khanmark/redcat51-flat-panel/docs/images/exploded.png

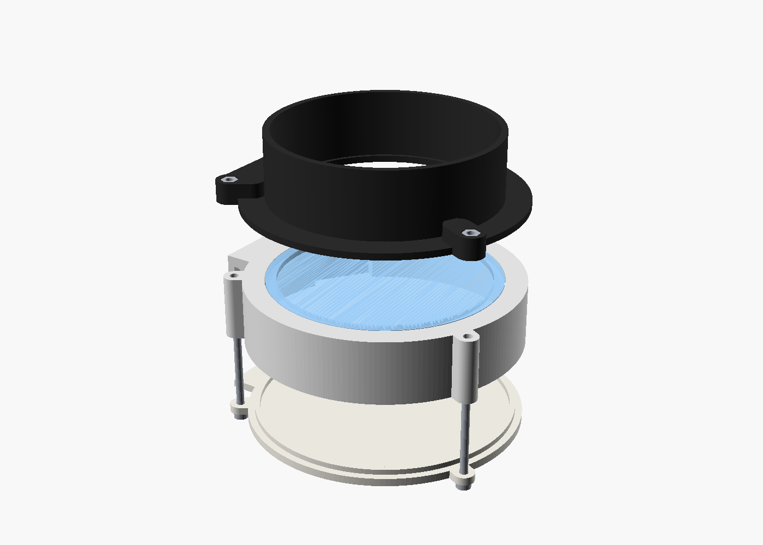
docs/images/exploded.png
