khanmark/redcat51-flat-panel/docs/images/nut_pocket_detail.png

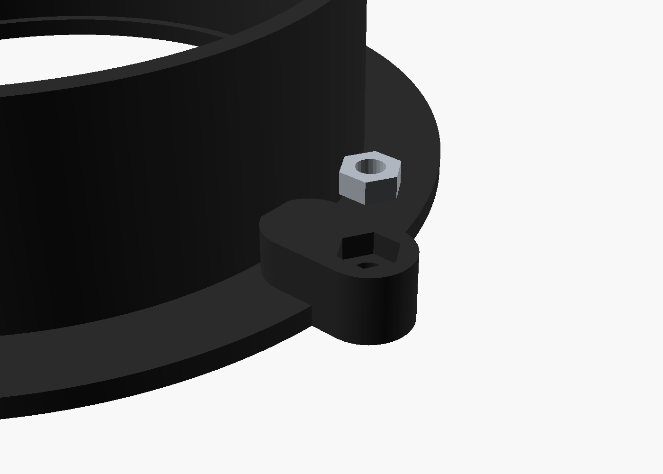
docs/images/nut_pocket_detail.png
