khanmark/redcat51-flat-panel/optional/flat_panel_collar_heat_insert.stl

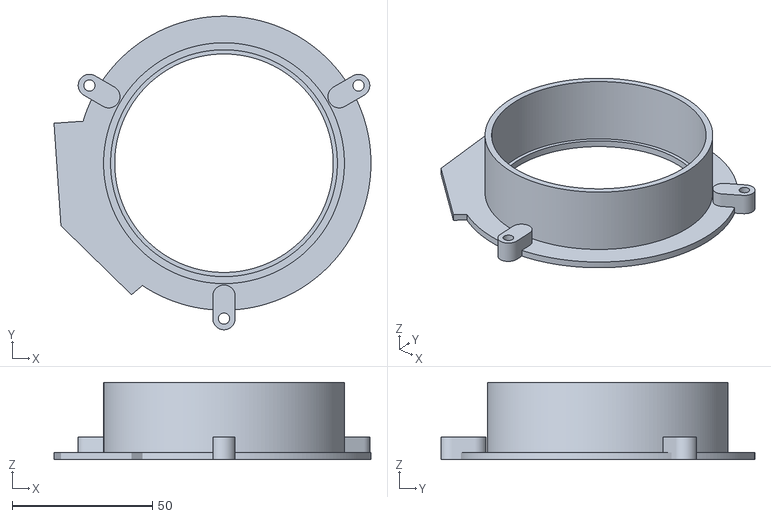
[picture p14: CAD file, 2026-10-26]
optional/flat_panel_collar_heat_insert.stl
113.2 x 112.0 x 27.5
