khanmark/redcat51-flat-panel/optional/flat_panel_diffuser_0.6mm.stl

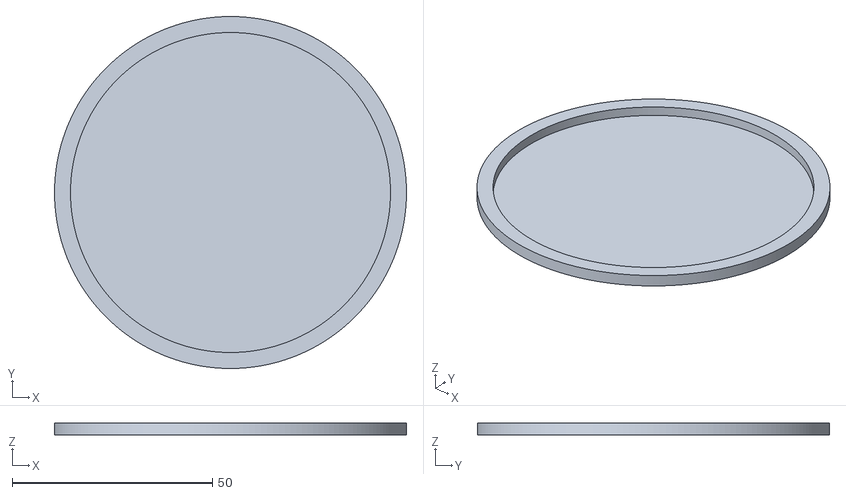
[picture p15: CAD file, 2026-10-26]
optional/flat_panel_diffuser_0.6mm.stl
88.0 x 88.0 x 3.00
