khanmark/redcat51-flat-panel/stl/flat_panel_diffuser.stl

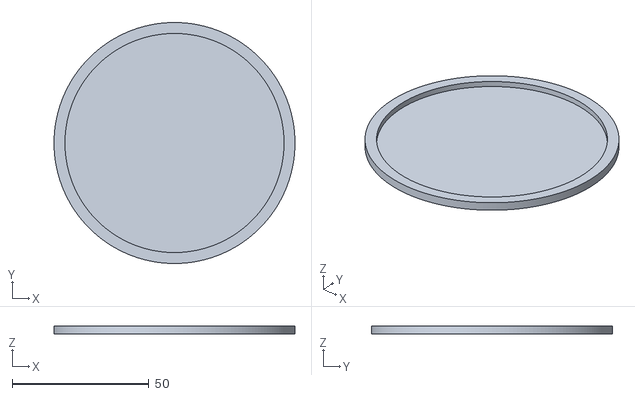
[picture p16: CAD file, 2026-10-26]
stl/flat_panel_diffuser.stl
88.0 x 88.0 x 3.00
