khanmark/redcat51-flat-panel/optional/acrylic_diffuser_88mm.dxf

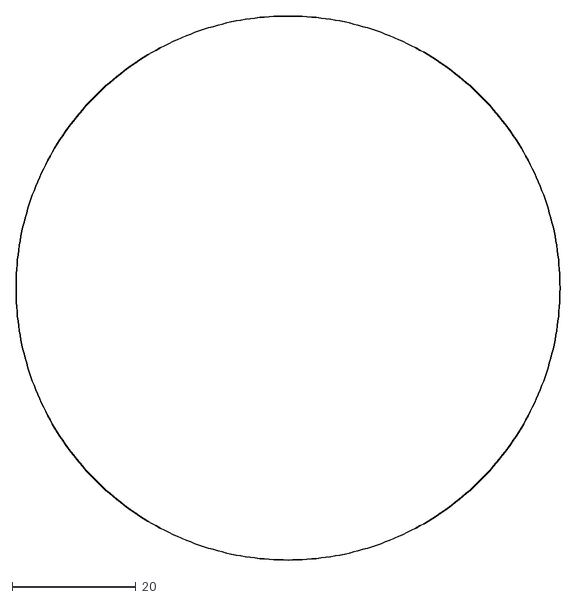
[picture p17: CAD file, 2026-10-26]
optional/acrylic_diffuser_88mm.dxf
88.0 x 88.0
