khanmark/redcat51-flat-panel/stl/flat_panel_surround.stl

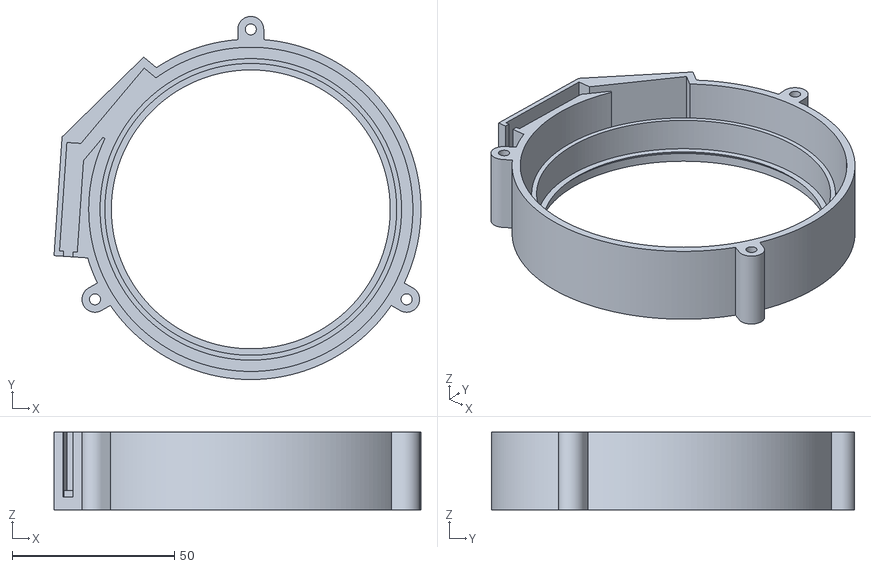
[picture p18: CAD file, 2026-10-26]
stl/flat_panel_surround.stl
113.2 x 112.0 x 24.0
