khanmark/redcat51-flat-panel/stl/flat_panel_back.stl

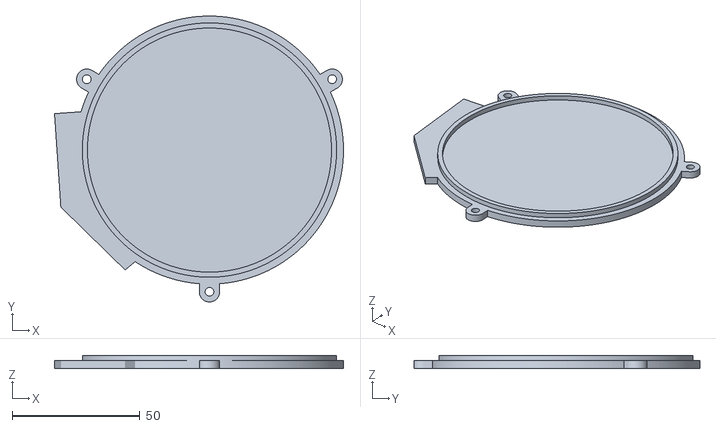
[picture p19: CAD file, 2026-10-26]
stl/flat_panel_back.stl
113.2 x 112.0 x 5.00
