khanmark/redcat51-flat-panel/scad/flat_panel.scad

// Slip-on flat-field panel for the William Optics RedCat 51 II.
//
// QUICK START: pick a part below, render (F6) and export (File > Export > STL).
// Or run scad/export_stls.sh to export every STL in one go. For a different scope, change only
// collar_id and diffuser_d (see the README appendix); everything else follows from those two.
//
// Print orientations (as modelled, no supports):
//   back       - flat on the bed, spigot up. Print in WHITE (exported mirrored, see the bottom of this file)
//   surround   - front face (diffuser recess) down
//   collar     - flange down; an M3 nut pocket in the free end of each tab (exported mirrored)
//   diffuser   - flat face on the bed, rim up
//   collar_heat_insert - optional collar for M3 heat-set inserts instead of nuts (exported mirrored)
//
// Assembly, front to back: collar flange -> diffuser (in the surround's front recess) -> surround -> back wall.
// Three M3x35 bolts go in from the back wall, through the surround lugs and collar tabs, into the nuts.

part = "all"; // [all, exploded, collar, surround, back, diffuser, collar_heat_insert]

/* [Fit to your scope] */
collar_id    = 81;    // inside diameter of the slip-on collar: measure your scope's dew shield and add about 1 mm
collar_depth = 25;    // how far the collar slides on

/* [Diffuser] */
diffuser_d        = 88;   // diffuser disc diameter
diffuser_t        = 3;    // recess depth = disc thickness at its edge (the collar flange clamps it)
diffuser_center_t = 1.0;  // thickness of the thin light-passing centre (the optional thinner diffuser uses 0.6)
diffuser_rim_w    = 4;    // width of the raised rim (keep it under the collar flange: > diffuser_d/2 - lip_id/2)

/* [Cavity] */
cavity_depth = 20;    // LED chamber depth. Deeper keeps bigger panels even (see the README appendix)

/* [Advanced: the defaults fit the parts in the BOM] */
wall         = 2.5;   // wall thickness of the collar and surround
flange_t     = 2.5;   // collar flange that clamps the diffuser
front_t      = 4;     // front ring thickness (includes the diffuser recess)
skirt_t      = 1.5;   // baffle skirt thickness (the skirt hides the LEDs from the diffuser)
back_t       = 3;     // back wall plate
spigot_h     = 2;     // locating ring on the back wall
spigot_w     = 2;
spigot_clear = 0.2;   // per side
// Wire exit: an open slot through the side of the connector box, so the wires leave the connector straight
wire_angle   = 140;   // where around the circle the connector box and converter pocket sit
slot_w       = 4;     // radial width of the connector-to-converter slot
dc_slot_w    = 3;     // DC lead exit slot in the far end of the converter pocket
// Strip connector: a solderless clip that slides down a channel from the open back (a soldered joint fits too)
conn_w       = 11.5;  // across the strip (axial)
conn_l       = 13.5;  // along the strip (tangential)
conn_t       = 4.2;   // thickness (radial)
conn_clear   = 0.5;
// Buck converter ("puck") pocket: outside the main wall, next to the side slot; slides in from the back
puck_l       = 25.5;  // along the wall
puck_w       = 17;    // front-to-back
puck_t       = 4.5;   // thickness
puck_clear   = 0.5;
puck_clear_l = 4;     // extra room along the wall (per end) for leads and fingers
puck_wall    = 1.6;
// Fasteners
lug_d        = 8;
screw_clear  = 3.4;
insert_d     = 4.0;   // heat-insert collar only: tab hole size, check your insert's recommended hole
insert_tab_t = 8;
lug_angles   = [90, 210, 330];
// Nut pockets: a hex nut sits in a pocket in the free (scope-side) end of each collar tab
nut_af       = 5.5;   // M3 nut, across flats
nut_h        = 2.4;   // M3 nut thickness
nut_clear    = 0.2;   // extra clearance per side (raise it if your nuts will not drop in)
nut_tab_d    = 10;    // collar tab width with nut pockets (wider than lug_d so the pocket keeps walls)

/* [Hidden] */
// Worked out from collar_id, diffuser_d and cavity_depth. They are not Customizer knobs, but you can still
// override any of them from the command line, e.g. -D skirt_len=17
lip_id            = collar_id - 3;        // internal stop lip: the scope bottoms out here (must clear your optics)
diffuser_recess_d = diffuser_d + 0.5;     // recess the disc sits in
seat_id           = diffuser_d - 2;       // light opening; the disc rests on this ring
skirt_id          = diffuser_d + 2;
cavity_id         = diffuser_d + 12;      // room for the skirt, LED strip and its wall
skirt_len         = cavity_depth / 2;     // never less than your strip width (10 mm)

$fn = 180;

outer_d    = cavity_id + 2 * wall;          // 105
lug_r      = outer_d / 2 + lug_d / 2 - 1;   // 55.5
surround_h = front_t + cavity_depth;        // 24

module lug_pads(h, d = lug_d) {
    for (a = lug_angles) rotate(a) hull() {
        translate([lug_r, 0, 0]) cylinder(d = d, h = h);
        translate([outer_d / 2 - 5, 0, 0]) cylinder(d = d, h = h);
    }
}

module lug_holes(d, h) {
    for (a = lug_angles) rotate(a)
        translate([lug_r, 0, -1]) cylinder(d = d, h = h + 2);
}

skirt_or   = skirt_id / 2 + skirt_t;                  // 46.5
chan_extra = 2;                                       // extra outward room so wires can exit beside the main wall
chan_out_r = skirt_or + conn_t + conn_clear + chan_extra;  // 53.2 - outer face of the connector channel
chan_len   = conn_l + 2 * conn_clear + 10;            // tangential length: connector + ~5mm each end for the wire bend
bump_wall  = 2.3;

// local thickening of the outer wall so the channel has a wall behind it
module conn_bump(h = surround_h) {
    rotate(wire_angle) translate([cavity_id / 2 - 2, -(chan_len / 2 + 2.5), 0])
        cube([chan_out_r + bump_wall - (cavity_id / 2 - 2), chan_len + 5, h]);
}

// buck converter pocket, placed tangent to the main wall right after the connector box
wall_or      = outer_d / 2;                                       // 52.5
pk_in_l      = puck_l + 2 * puck_clear_l;                         // 33.5
pk_in_w      = puck_w + 2 * puck_clear;                           // 18
pk_in_t      = puck_t + 2 * puck_clear;                           // 5.5
pk_half      = pk_in_l / 2 + puck_wall;
bump_half    = chan_len / 2 + 2.5;
pk_angle     = wire_angle + (bump_half + pk_half) / wall_or * 180 / PI;
pk_floor     = surround_h - pk_in_w;                              // pocket open to the back edge

module puck_body(h = surround_h) {
    rotate(pk_angle) translate([cavity_id / 2 - 2, -pk_half, 0])
        cube([wall_or + pk_in_t + puck_wall - (cavity_id / 2 - 2), 2 * pk_half, h]);
}

// connector box + converter pocket as one continuous outside shape
module side_body(h = surround_h) { hull() { conn_bump(h); puck_body(h); } }

module puck_void() {
    rotate(pk_angle) {
        translate([wall_or, -pk_in_l / 2, pk_floor]) cube([pk_in_t, pk_in_l, surround_h]);
        // DC lead exit through the far end wall, open to the back edge
        translate([wall_or + (pk_in_t - dc_slot_w) / 2, pk_in_l / 2 - 1, front_t]) cube([dc_slot_w, puck_wall + 2, surround_h]);
    }
}

// open slot through one side wall of the box, from the front ring to the back edge (back wall closes the top)
module side_slot() {
    rotate(wire_angle) translate([chan_out_r - slot_w, chan_len / 2 - 1, front_t])
        cube([slot_w, 2.5 + 8, surround_h]);   // runs through into the buck converter pocket
}

// full-height channel at the strip-joint location; connector drops in from the back, rests on the front ring
module conn_channel() {
    rotate(wire_angle) translate([skirt_or + 0.5, -chan_len / 2, front_t])
        cube([chan_out_r - skirt_or - 0.5, chan_len, surround_h]);
}

module back_wall() {
    difference() {
        union() {
            cylinder(d = outer_d, h = back_t);
            side_body(back_t);     // match the surround's outline
            lug_pads(back_t);
            translate([0, 0, back_t]) difference() {
                cylinder(d = cavity_id - 2 * spigot_clear, h = spigot_h);
                translate([0, 0, -1])
                    cylinder(d = cavity_id - 2 * spigot_clear - 2 * spigot_w, h = spigot_h + 2);
            }
        }
        lug_holes(screw_clear, back_t + spigot_h);
    }
}

module surround() {
    difference() {
        union() {
            cylinder(d = outer_d, h = surround_h);
            lug_pads(surround_h);
            side_body();
        }
        translate([0, 0, front_t]) cylinder(d = cavity_id, h = surround_h);
        conn_channel();
        translate([0, 0, -1]) cylinder(d = seat_id, h = front_t + 2);
        // diffuser recess with a 45-degree seat (no flat overhang); 88mm disc lands flush with front face
        chamfer_h = (diffuser_recess_d - seat_id) / 2;
        flat_h    = diffuser_t - (diffuser_recess_d - diffuser_d) / 2;
        translate([0, 0, -1]) cylinder(d = diffuser_recess_d, h = flat_h + 1);
        translate([0, 0, flat_h - 0.01])
            cylinder(d1 = diffuser_recess_d, d2 = seat_id, h = chamfer_h + 0.01);
        lug_holes(screw_clear, surround_h);
        side_slot();
        puck_void();
    }
    translate([0, 0, front_t]) difference() {
        cylinder(d = skirt_id + 2 * skirt_t, h = skirt_len);
        translate([0, 0, -1]) cylinder(d = skirt_id, h = skirt_len + 2);
    }
}

// nut_pocket = true (default): an M3 nut pocket in the free end of each tab, open at the top as printed (flange
// down), so the nut drops in from above. The bolt (M3x35: 3 back wall + 24 surround + 8 tab) just reaches through
// the nut. nut_pocket = false: plain tabs with insert_d holes for heat-set inserts (part = "collar_heat_insert").
module collar(nut_pocket = true) {
    difference() {
        union() {
            cylinder(d = outer_d, h = flange_t);
            side_body(flange_t);   // match the surround's outline
            lug_pads(insert_tab_t, nut_pocket ? nut_tab_d : lug_d);
            cylinder(d = collar_id + 2 * wall, h = flange_t + collar_depth);
        }
        translate([0, 0, -1]) cylinder(d = lip_id, h = 100);
        translate([0, 0, flange_t]) cylinder(d = collar_id, h = 100);
        lug_holes(nut_pocket ? screw_clear : insert_d, insert_tab_t);
        if (nut_pocket) for (a = lug_angles) rotate(a)       // hex corners point along the tab, flats across it
            translate([lug_r, 0, insert_tab_t - (nut_h + 0.2)])
                cylinder(d = (nut_af + 2 * nut_clear) / cos(30), h = nut_h + 0.2 + 1, $fn = 6);
    }
}

// 3D-printed diffuser: a thin centre (diffuser_center_t) lets the light through, and a raised rim up to
// diffuser_t fills the rest of the recess so the collar flange still clamps the disc. The flat face is the
// back (LED side); the rim is on the front face, under the flange. If diffuser_center_t >= diffuser_t it is a plain disc.
module diffuser() {
    cylinder(d = diffuser_d, h = min(diffuser_center_t, diffuser_t));
    if (diffuser_center_t < diffuser_t) difference() {
        cylinder(d = diffuser_d, h = diffuser_t);
        translate([0, 0, -1]) cylinder(d = diffuser_d - 2 * diffuser_rim_w, h = diffuser_t + 2);
    }
}

module assembly(gap = 0) {
    collar();
    translate([0, 0, -gap]) mirror([0, 0, 1]) surround();
    translate([0, 0, -surround_h - back_t - 2 * gap]) back_wall();
}

// The collar and the back wall get flipped over relative to the surround when the panel is assembled, so
// they are exported MIRRORED (y -> -y): that makes their outlines (lugs, wire-exit box) line up with the
// surround's. The STLs in stl/ and optional/ are already mirrored; do not mirror them again in the slicer.
if (part == "back")          mirror([0, 1, 0]) back_wall();
else if (part == "surround") surround();
else if (part == "collar")   mirror([0, 1, 0]) collar();
else if (part == "collar_heat_insert") mirror([0, 1, 0]) collar(false);
else if (part == "diffuser") diffuser();
else if (part == "exploded") assembly(25);
else                         assembly(0);
