khanmark/redcat51-flat-panel/(list of files, cad)

Other CAD files:
stl/flat_panel_collar.stl
