khanmark/redcat51-flat-panel/(commit log)

2026-10-26 Initial commit: RedCat 51 II flat panel
    Parametric OpenSCAD source, ready-to-print STLs (including a 3D-printed
    diffuser in 0.6 mm and 1.0 mm), acrylic diffuser DXF, one-page BOM PDF with
    short Amazon links, rendered images, and a README covering assembly, optional
    components, scaling the SCAD, and the limits of scaling up.
    [diffuser_0.6mm.stl, diffuser_1.0mm.stl, diffuser_88mm.dxf, flat_panel.scad, flat_panel_back.stl, flat_panel_collar.stl, flat_panel_surround.stl, surround_for_0.6mm_diffuser.stl]
2026-10-26 Add optional nut-trap collar (M3x35 bolts)
    New collar_nut_trap part: hex pockets for standard M3 nuts on the
    surround side of each collar tab, closed by the surround lug, so shorter
    M3x35 bolts can be used. Includes exported STL, nut-trap parameters,
    README section and assembly notes, BOM note, and close-up image.
    [flat_panel.scad, flat_panel_collar_nut_trap.stl, views.scad]
2026-10-26 Make the 1.0 mm printed diffuser the default build
    The printed diffuser is now a thin 1.0 mm centre with a raised rim that fills
    the surround's 3 mm recess, so one surround fits the printed diffuser (1.0 or
    0.6 mm centre) and 3 mm acrylic. The old matching-surround STLs are removed.
    - scad: diffuser_center_t / diffuser_rim_w, rim-up printed diffuser part
    - stl/ is now the default build (collar, surround, back, diffuser);
    optional/ holds the 0.6 mm diffuser, nut-trap collar and acrylic DXF
    - README and BOM reworded around the new default
    [acrylic_diffuser_88mm.dxf, diffuser_0.6mm.stl, diffuser_1.0mm.stl, flat_panel.scad, flat_panel_collar_nut_trap.stl, flat_panel_diffuser.stl, flat_panel_diffuser_0.6mm.stl, surround_for_0.6mm_diffuser.stl]
2026-10-26 Move nut-trap pocket to the free end of the collar tab
    The M3 nut pocket was on the flange face (against the surround). It is now
    recessed into the free, scope-side end of each tab, open at the top as
    printed, so the nut drops in from above and nothing needs bridging. README,
    labels and images updated.
    [flat_panel.scad, flat_panel_collar_nut_trap.stl, views.scad]
2026-10-26 Make M3x35 the standard bolt; nut-pocket collar is now the default
    The collar with an M3 nut pocket in each tab end is now the standard collar
    (stl/flat_panel_collar.stl) and every build uses M3x35 bolts. The old
    nut-on-the-tab-end build (M3x40) is removed. Plain tabs with heat-insert holes
    remain as optional/flat_panel_collar_heat_insert.stl.
    - scad: collar() defaults to nut pockets; part = collar_heat_insert for inserts
    - README, BOM and images updated; bolt-length rule is cavity_depth + 15
    [flat_panel.scad, flat_panel_collar.stl, flat_panel_collar_heat_insert.stl, flat_panel_collar_nut_trap.stl, views.scad]
2026-10-26 Fix collar handedness: export collar and back wall mirrored
    The regenerated collar STLs were the wrong hand (unmirrored): the original
    build's collar and back wall are mirrored (y -> -y) relative to the scad's
    part output so they line up with the surround once flipped over. The scad
    now exports collar, collar_heat_insert and back mirrored, and the collar
    STLs are regenerated. Verified against the original STLs: the heat-insert
    collar and back wall match them, and the surround flipped over matches the
    back wall. README documents the mirroring.
    [flat_panel.scad, flat_panel_collar.stl, flat_panel_collar_heat_insert.stl, views.scad]
2026-10-26 README: add note on extending the DC pigtail wire
2026-10-26 README: note the wire length needed between strip and converter
2026-10-26 README: optional strain-relief step with low-temp hot glue
2026-11-04 README: required build first, optional extras isolated, scad simplified, to-do list
    - README now describes only the tested RedCat build: four printed parts, nine assembly steps.
    Untested-item caveats and the acrylic diffuser option are gone.
    - All optional items (0.6 mm diffuser, heat-set inserts, solderless connectors, strain relief, flux)
    moved to one Optional extras section that says which step each changes.
    - Scaling and limits material moved to a clearly marked unverified appendix.
    - Assembly: 1-2 inch wire between converter and strip stated up front and in step 3.
    - New To do section: puck access for dimming, wireless control, N.I.N.A. dimming plugin.
    - scad: lip_id, recess, seat,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
    [flat_panel.scad]
2026-11-04 Drop tool and optional-item costs; focus on the build
    - README: the pack-price line now gives only the \$77.73 build total.
    - BOM: Tools and misc lists the tools without prices or a subtotal. BOM.pdf regenerated from bom.html.
2026-11-04 README: drop price caveat and mirroring note, add strip adhesive step, trim dimming repeats
    - Remove the single-item price/shipping/tax sentence.
    - Printing: say to print every STL in its original orientation; no mirroring talk.
    - Step 5: the strip's adhesive backing is peeled only if it should stick to the surround.
    - Set-the-brightness message now appears in the top callout, step 7 and one line in Using it.
2026-11-04 README: remove the total BOM cost line
2026-11-04 Treat the diffuser as one of the four printed parts; note the acrylic fallback
    - README and BOM no longer list the diffuser as a separate item.
    - Diffuser section: a one-line note to cut a 3 mm acrylic disc from the DXF if the thin centre won't print.
2026-11-05 Update README with additional assembly information
    Added details about soldering points and assembly considerations.
2026-11-05 Clarify LED strip orientation and adhesive instructions
    Updated instructions for LED strip installation to clarify the orientation of the LEDs and adhesive backing usage.
